UBC-Rocket/WB-AV-4510-CAN/README.md

# Whistler Blackcomb Data Acquisition Board

Altium PCB files for Whistler Blackcomb's Data acquisition boards. There will be three of these on the final rocket connected to our main flight computer. The firmware for this PCB can be found [here](https://github.com/UBC-Rocket/WB-DAQ-Firmware). 
