UBC-Rocket/WB-AV-4510-CAN/WB-AV-4510-DAQ-BOM-INSTOCK-REVA.xlsx

Index | Quantity x2 | Quantity x3 | Quantity | Part Number | Manufacturer Part Number | Description | Customer Reference |  | Available | Backorder | Unit Price | Extended Price CAD
1 | 4 | 6 | 2 | 57478446 | 5747844-6 | CONN D-SUB RCPT 9POS R/A SLDR | J1, J4 |  | 0 | 2 | 4.24 | 8.48
2 | 4 | 6 | 2 | SAM1222-02-ND | SSW-102-02-T-S | CONN RCPT 2POS 0.1 TIN PCB | J2, J3 |  | 2 | 0 | 0.39 | 0.78
3 | 8 | 12 | 4 | A34091-ND | 1-5747150-6 | CONN D-SUB RCPT 9POS VERT SLDR | J7, J8, J9, J10 |  | 4 | 0 | 9.36 | 37.44
4 | 2 | 3 | 1 | SAM8799-ND | FTSH-105-01-L-DV-K | CONN HEADER SMD 10POS 1.27MM | P1 |  | 0 | 1 | 3.94 | 3.94
5 | 2 | 3 | 1 | 568-13334-ND | MK66FX1M0VLQ18 | IC MCU 32BIT 1MB FLASH 144LQFP | U4 |  | 1 | 0 | 33.56 | 33.56
6 | 46 | 69 | 23 | 478-3726-1-ND | 0603YC104JAT2A | CAP CER 0.1UF 16V X7R 0603 | C25-C32, C6-C15, C59, C65, C70, C75, C76 | C25-C32, C6-C15, C59, C65, C70, C75, C76 | 18 | 0 | 0.201 | 3.62
7 | 8 | 12 | 4 | MCP33121-05-E/MS-ND | MCP33121-05-E/MS | IC ADC 14BIT SAR 10MSOP | *1, *3, *5, *7 |  | 4 | 0 | 5.76 | 23.04
8 | 6 | 9 | 3 | 490-6389-1-ND | GRM1885C2A101JA01J | CAP CER 100PF 100V C0G/NP0 0603 | C1, C2, C3 |  | 3 | 0 | 0.15 | 0.45
9 | 4 | 6 | 2 | 1276-2064-1-ND | CL10B472KB8NFNC | CAP CER 4700PF 50V X7R 0603 | C4, C5 |  | 2 | 0 | 0.14 | 0.28
10 | 2 | 3 | 1 | 399-8147-1-ND | C1206C105K5RACTU | CAP CER 1UF 50V X7R 1206 | C24 |  | 1 | 0 | 0.38 | 0.38
11 | 4 | 6 | 2 | 732-7566-1-ND | 885012208019 | CAP CER 22UF 10V X7R 1206 | C33, C34 |  | 2 | 0 | 1.05 | 2.10
12 | 4 | 6 | 2 | 399-3229-1-ND | C1206C226K9PACTU | CAP CER 22UF 6.3V X5R 1206 | C37, C38 |  | 2 | 0 | 0.73 | 1.46
13 | 2 | 3 | 1 | 1276-2003-1-ND | CL10B223KB8NNWC | CAP CER 0.022UF 50V X7R 0603 | C39 |  | 1 | 0 | 0.14 | 0.14
14 | 8 | 12 | 4 | 1276-2876-1-ND | CL31A106KBHNNNE | CAP CER 10UF 50V X5R 1206 | C40, C41, C48, C49 |  | 4 | 0 | 0.46 | 1.84
15 | 8 | 12 | 4 | 493-2286-1-ND | UUD1V330MCL1GS | CAP ALUM 33UF 20% 35V SMD | C42, C43, C50, C51 |  | 4 | 0 | 0.71 | 2.84
16 | 8 | 12 | 4 | 399-1155-1-ND | C0805C472K5RACTU | CAP CER 4700PF 50V X7R 0805 | C44, C45, C52, C54 |  | 4 | 0 | 0.14 | 0.56
17 | 8 | 12 | 4 | 399-6944-1-ND | C0805C223K1RACAUTO | CAP CER 0.022UF 100V X7R 0805 | C46, C47, C53, C55 |  | 4 | 0 | 0.49 | 1.96
 | 16 | 24 | 8 | 587-1242-1-ND |  |  | C57,60,62,63,67,68,71,73
~~18~~ | ~~42~~ | ~~63~~ | ~~21~~ | ~~478-3714-1-ND~~ | ~~06033C104KAT2A~~ | ~~CAP CER 0.1UF 25V X7R 0603~~ | ~~C56-C76~~ |  | ~~21~~ | ~~0~~ | ~~0.057~~ | ~~1.20~~
19 | 4 | 6 | 2 | 1727-1349-1-ND | PMEG6030EVPX | DIODE SCHOTTKY 60V 3A SOD128 | D3, D4 |  | 2 | 0 | 0.61 | 1.22
20 | 2 | 3 | 1 | SMAJ24A-E3/5AGICT-ND | SMAJ24A-E3/5A | TVS DIODE 24V 38.9V DO214AC | D5 |  | 1 | 0 | 0.53 | 0.53
21 | 2 | 3 | 1 | 609-4616-1-ND | 10118193-0001LF | CONN RCPT USB2.0 MICRO B SMD R/A | J5 |  | 1 | 0 | 0.65 | 0.65
22 | 2 | 3 | 1 | 114-00841-68-1-ND | 114-00841-68 | CONN MICRO SD CARD PUSH-PULL R/A | J6 |  | 1 | 0 | 1.71 | 1.71
23 | 2 | 3 | 1 | 732-1266-1-ND | 744774047 | FIXED IND 4.7UH 3A 71 MOHM SMD | L1 |  | 1 | 0 | 2.55 | 2.55
24 | 20 | 30 | 10 | 732-4994-1-ND | 150120YS75000 | LED YELLOW CLEAR 1206 SMD | LED1, LED2, LED3, LED4, LED5, LED6, LED7, LED8, |  | 10 | 0 | 0.29 | 2.90
25 | 2 | 3 | 1 | 732-4993-1-ND | 150120VS75000 | LED GREEN CLEAR 1206 SMD | LED9 |  | 1 | 0 | 0.29 | 0.29
26 | 2 | 3 | 1 | 732-4989-1-ND | 150120BS75000 | LED BLUE CLEAR 1206 SMD | LED12 |  | 1 | 0 | 0.29 | 0.29
27 | 2 | 3 | 1 | 732-4991-1-ND | 150120RS75000 | LED RED CLEAR 1206 SMD | LED13 |  | 1 | 0 | 0.29 | 0.29
28 | 2 | 3 | 1 | XC1839CT-ND | ECS-160-8-30B-CKM | CRYSTAL 16.0000MHZ 8PF SMD | OSCILLATOR1 |  | 1 | 0 | 1.46 | 1.46
29 | 30 | 45 | 15 | 13-RT0603BRD0722RLCT-ND | RT0603BRD0722RL | RES SMD 22 OHM 0.1% 1/10W 0603 | R1-R6,R60-R63,R20-R24 |  | 15 | 0 | 0.396 | 5.94
30 | 2 | 3 | 1 | 541-1.00KHCT-ND | CRCW06031K00FKEA | RES SMD 1K OHM 1% 1/10W 0603 | R7 |  | 1 | 0 | 0.14 | 0.14
31 | 8 | 12 | 4 | P1.00MLCT-ND | ERJ-2RKF1004X | RES SMD 1M OHM 1% 1/10W 0402 | R25, R27, R31, R33 |  | 4 | 0 | 0.14 | 0.56
32 | 2 | 3 | 1 | P330HCT-ND | ERJ-3EKF3300V | RES SMD 330 OHM 1% 1/10W 0603 | R38 |  | 1 | 0 | 0.14 | 0.14
33 | 2 | 3 | 1 | 311-150HRCT-ND | RC0603FR-07150RL | RES SMD 150 OHM 1% 1/10W 0603 | R40 |  | 1 | 0 | 0.14 | 0.14
34 | 2 | 3 | 1 | P18.0KHCT-ND | ERJ-3EKF1802V | RES SMD 18K OHM 1% 1/10W 0603 | R43 |  | 1 | 0 | 0.14 | 0.14
35 | 2 | 3 | 1 | 541-6.20KHCT-ND | CRCW06036K20FKEA | RES SMD 6.2K OHM 1% 1/10W 0603 | R44 |  | 1 | 0 | 0.14 | 0.14
36 | 2 | 3 | 1 | 541-16.0KHCT-ND | CRCW060316K0FKEA | RES SMD 16K OHM 1% 1/10W 0603 | R45 |  | 1 | 0 | 0.14 | 0.14
37 | 2 | 3 | 1 | 311-2105-1-ND | AT0603DRD0710KL | RES SMD 10K OHM 0.5% 1/10W 0603 | R46 |  | 1 | 0 | 0.3 | 0.30
38 | 8 | 12 | 4 | P34KDACT-ND | ERA-6AEB3402V | RES 34K OHM 0.1% 1/8W 0805 | R50, R51, R56, R57 |  | 4 | 0 | 0.45 | 1.80
39 | 8 | 12 | 4 | YAG4965CT-ND | RT0805BRE071K18L | RES SMD 1.18K OHM 0.1% 1/8W 0805 | R52, R53, R58, R59 |  | 4 | 0 | 0.58 | 2.32
40 | 2 | 3 | 1 | P8047SCT-ND | EVQ-PLMA15 | SWITCH TACTILE SPST-NO 0.02A 15V | SW1 |  | 1 | 0 | 0.52 | 0.52
41 | 2 | 3 | 1 | 568-8681-1-ND | TJA1048T,118 | IC TRANSCEIVER HALF 2/2 14SO | U1 |  | 0 | 1 | 3.23 | 3.23
42 | 8 | 12 | 4 | MCP6286T-E/OTCT-ND | MCP6286T-E/OT | IC OPAMP GP 1 CIRCUIT SOT23-5 | U6, U7, U8, U9 |  | 4 | 0 | 0.82 | 3.28
43 | 2 | 3 | 1 | MCP1501T-20E/CHYCT-ND | MCP1501T-20E/CHY | IC VREF SERIES 0.1% SOT23-6 | U10 |  | 0 | 1 | 1.16 | 1.16
44 | 2 | 3 | 1 | MCP9808T-E/MSCT-ND | MCP9808T-E/MS | SENSOR DIGITAL -40C-125C 8MSOP | U11 |  | 1 | 0 | 1.63 | 1.63
45 | 2 | 3 | 1 | TS30042-M050QFNRCT-ND | TS30042-M050QFNR | IC REG BUCK 5V 2A 16QFN | U18 |  | 0 | 1 | 3.53 | 3.53
46 | 8 | 12 | 4 | 732-6215-1-ND | 171032401 | DC DC CONVERTER 5-24V | U19, U20, U21, U22 |  | 4 | 0 | 23.28 | 93.12
47 | 16 | 24 | 8 | 720-1526-1-ND | VJ0603A101JXACW1BC | CAP CER 100PF 50V C0G/NP0 0603 | C16, C17, C18, C19, C20, C21, C22, C23 |  | 8 | 0 | 0.15 | 1.20
48 | 16 | 24 | 8 | P2.0MJCT-ND | ERJ-2GEJ205X | RES SMD 2M OHM 5% 1/10W 0402 | R26, R28, R29, R30, R32, R34, R35, R36 |  | 8 | 0 | 0.14 | 1.12
49 | 2 | 3 | 1 | 1727-3827-1-ND | PESD3V3L4UG,115 | TVS DIODE 3.3V 12V 5TSSOP | U5 |  | 1 | 0 | 0.49 | 0.49
50 | 8 | 12 | 4 | MCP96L00-E/MX | MCP96L00-E/MX | IC THERMOCOUPLE TO I2C 20MQFN | U12, U13, U14, U15 |  | 0 | 4 | 10.27 | 41.08
51 | 4 | 6 | 2 | 445-5205-1-ND | C2012X7S2A105K125AB | CAP CER 1UF 100V X7S 0805 | C35, C36 |  | 2 | 0 | 0.65 | 1.30
52 | 4 | 6 | 2 | SZNUP2105LT1GOSCT-ND | SZNUP2105LT1G | TVS DIODE 24V 44V SOT23-3 | D1, D2 |  | 2 | 0 | 0.56 | 1.12
53 | 4 | 6 | 2 | 296-47565-1-ND | TVS3300DRVR | TVS MIXED TECHNOLOGY 40VC 6WSON | U2, U3 |  | 2 | 0 | 0.94 | 1.88
54 | 2 | 3 | 1 | 296-50411-1-ND | TLV75533PDBVR | IC REG LINEAR 3.3V 500MA SOT23-5 | U16 |  | 1 | 0 | 0.61 | 0.61
55 | 2 | 3 | 1 | 296-47292-1-ND | TPS26600PWPR | IC PWR MGMT EFUSE 60V 16HTSSOP | U17 |  | 0 | 1 | 4.02 | 4.02
56 | 20 | 30 | 10 | RHM680AYCT-ND | KTR03EZPF6800 | RES SMD 680 OHM 1% 1/10W 0603 | R12, R13, R14, R15, R16, R17, R18, R19 |  | 10 | 0 | 0.187 | 1.87
57 | 6 | 9 | 3 | 541-1.5KAYCT-ND | CRCW06031K50DHEAP | RES SMD 1.5K OHM 0.5% 1/10W 0603 | R37, R39, R41 |  | 3 | 0 | 0.42 | 1.26
~~58~~ | ~~2~~ | ~~3~~ | ~~1~~ | ~~738-RMCF0603FT30R0CT-ND~~ | ~~RMCF0603FT30R0~~ | ~~RES 30 OHM 1% 1/10W 0603~~ | ~~R47~~ |  | ~~1~~ | ~~0~~ | ~~0.14~~ | ~~0.14~~
59 | 8 | 12 | 4 | RHM499KAHCT-ND | KTR10EZPF4993 | RES SMD 499K OHM 1% 1/8W 0805 | R48, R49, R54, R55 |  | 4 | 0 | 0.25 | 1.00
60 | 2 | 3 | 1 | 50-ECS-.327-6-34QN-CT-ND | ECS-.327-6-34QN-TR | CRYSTAL 32.7680KHZ 6PF SMD | CRYSTAL1 |  | 1 | 0 | 1.13 | 1.13
 | 8 | 12 | 4 | 478-F981A106MMUAJ6CT-ND |  |  | C56,C61,C66,C72
 |  |  | 4 | 399-7867-1-ND |  |  | C58,C64,C69,C74
 |  |  | 1 | 2019-RK73H1JTTD7153FCT-ND |  |  | R42
 |  |  |  | RK73H1JTTD3002F (https://www.digikey.ca/en/products/detail/koa-speer-electronics-inc/RK73H1JTTD3002F/9844912) |  |  | R47
