UBC-Rocket/WB-AV-4510-CAN/(list of files, drawings)

Other design files:
24V Regulators.SchDoc
CANbus.SchDoc
DAQ and Actuators.SchDoc
MCU.SchDoc
Power.SchDoc
Temp_Sensor.SchDoc
Thermocouple.SchDoc
WB-AV-4510-CAN.PcbDoc
WB-AV-4510-CAN.PrjPcb
WB-AV-4510-CAN.SchDoc
WB-AV-4510-DAQ.PcbLib
WB-AV-4510-DAQ.SchLib
