UBC-Rocket/WB-AV-4510-CAN/(threads)

Thread 10 (2021-10-24):

U17 U18 E-Fuse and Switching Regulator Missing from board

davinbirdi, 2021-10-24:
**U17: E-Fuse (TPS26600PWPR)**
https://www.digikey.ca/en/products/detail/texas-instruments/TPS26600PWPR/6199305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
https://www.ti.com/lit/ds/symlink/tps2660.pdf?HQS=dis-dk-null-digikeymode-dsf-pf-null-wwe&ts=1635100487170

**U18: Voltage Regulator**
https://www.digikey.ca/en/products/detail/semtech-corporation/TS30042-M050QFNR/6605522

U17 is E-Fuse that inputs in the 7s net and outputs to the 7s_F net (presumably fused).
U18 is a Voltage regulator that inputs the 7s_F net and outputs to PG (then to 3.3V) and 5.5V

ToDo: Currently cannot connect 24V or 7s to board to power microcontroller and also toggle 24V outputs. Will look at getting the parts and adding to board.

Note: U1 also missing will do separate Issue

misprit7, 2021-11-23:
For now we can just power the board and high side switch separately, so this isn't the end of the world. For the next iteration of the PCB we'll place them.

Closed 2021-11-23.

Thread 12 (2021-11-23):

ADC SPI Pins Reversed

misprit7, 2021-11-23:
The MOSI and MISO pins of the 14 bit analog to digital converters are reversed, which means that we can't read their output. To fix this all that needs to be done is wire the MOSI and MISO pins to the MCU as they are except switched.

As a temporary stop gap if we really needed to use the ADCs before the next iteration we could bit bang SPI, but with an RTOS that might be tricky and given we won't use it in the long run I'd prefer not to.

Reference: [The ADCs in question](http://ww1.microchip.com/downloads/en/DeviceDoc/MCP33131-MCP33121-MCP33111-Family-Data-Sheet-DS20006122A.pdf)

misprit7, 2021-11-23:
Just to note that when I was debugging why I couldn't read from them I found that they were reading the given voltage seemingly correctly, so the rest of their connections are likely correct.

Closed 2022-01-12.

Thread 13 (2021-11-23):

Mirrored High Side Switches

misprit7, 2021-11-23:
The high side switches have pins that are mirrored to their actual functionality, presumably due to some misunderstanding of a bottom down/top down view. Right now we thought they were wired for SPI, but in reality we wired them to be controlled directly via digital inputs. To fix this issue we need to provide the correct pin assignments to Altium.

Whether we should try to keep SPI or just use the direct inputs is up for discussion, we'll have to talk about it. Especially now that we've quote-unquote "tested" the direct inputs, it might be easier to switch to that.

Reference: [High side switch datasheet](https://www.nxp.com/docs/en/data-sheet/MC06XS4200.pdf)

Closed 2022-01-12.

Thread 14 (2021-12-05):

Test Points Header Distances

davinbirdi, 2021-12-05:
Change the test point single probing points to constant header distances.

See the current board and how crooked the single headers are when soldered individually. Better to keep headers together.

misprit7, 2022-03-09:
Fixed on the latest version.

Closed 2022-03-09.

Thread 15 (2021-12-17):

Thermocouple I2C Pullup Resistors

misprit7, 2021-12-17:
The thermocouple amplifiers use I2C to communicate with the MCU, but the protocol requires pull up resistors for SDA and SCL that aren't there. To fix this we need to add pull up resistors on SDA1, SDA3, SCL1 and SCL3 (and whatever other I2C lines there are).

Also note that internal pull resistors might be a temporary fix, I haven't confirmed this yet. However this isn't a good long term solution because they have much too high of a resistance and will cause timing issues with the signal.

misprit7, 2021-12-19:
Just tested this more, surprisingly the communication actually works us even without external pullup resistors by instead using the internal pull up resistors of the chip. These resistors are too high by a factor of 4 or 5 to act as pullup resistors for normal I2C communication, but as long as you keep the baud rate relatively low it works fine. At a baud rate of 10,000 everything worked perfectly, but at around 100,000 errors started to pop up every so often. You can see the effect of the large RC constant when you probe it:

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

As good practice the next iteration should have pull up resistors regardless though. Also I tested all the thermocouple amplifiers and they seem to work (I didn't try and measure their precision or anything but they could detect that room temperature was ~20C and my finger was ~30C).

misprit7, 2022-03-09:
This was fixed by Eric a while ago, going to close this

Closed 2022-03-09.

Thread 18 (2022-01-28):

Floating Analog Ground & VREFL

davinbirdi, 2022-01-28:
Pin 33 is the VREFL for on-chip ADCs.

When reading from ADCs there is an offset of 800mv where it reads 0 and is consistent. The issue is being unable to measure below 800mV as the range only goes to -253 which stops at ~600mV.

Read page 1000 of the [big manual for application information.](https://www.pjrc.com/teensy/K66P144M180SF5RMV2.pdf)

We have temporarily connected a wire between this point and ground, but for the next revision please connect the via that seems to have been forgotten to be connected to the ground plane.

> 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

misprit7, 2022-03-09:
Fixed this, now AGND is tied directly to GND.

Closed 2022-03-09.

Thread 22 (2022-02-27):

Verify High-Side Switches are output to the correct pins of connectors

davinbirdi, 2022-02-27:
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

This looks nets aren't connected properly. If it is specifically done this way, it's all good; but it's not it might be better to have fixed.

misprit7, 2022-03-09:
This has been fixed, this was a result of the high side switch mixup.

Closed 2022-03-09.

Thread 23 (2022-03-02):

Fix Compiler Warnings

misprit7, 2022-03-02:
Fix all the compiler warnings/errors currently generated on the schematic side of things.

misprit7, 2022-03-02:
Also fixed AGND being completely isolated from GND by connecting them.

misprit7, 2022-03-02:
A note about why this is necessary: this would have been uncaught other wise:
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
The +5 there should be +5V, which would surely cause stuff to just not work since the power wouldn't be connected.

misprit7, 2022-03-09:
This has been finished.

Closed 2022-03-09.

Thread 26 (2022-03-13):

Purchase PCB

misprit7, 2022-03-13:
Buy the Rev C PCB from JLCPCB.

misprit7, 2022-03-13:
I want to do a review of both this and the FC tomorrow before we order though.

Esouder, 2022-03-13:
Final checks:

- [ ] Hi-side switch pins
- [ ] ADC MISO/MOSI
- [ ] TC Pullups

Esouder, 2022-03-27:
🎉🎉🎉

Closed 2022-03-27.
