UBC-Rocket/WB-AV-4510-CAN/(commit log)

2020-09-01 added connectors and CAN ICs
    [WB-AV-4510-CAN.PcbDoc, WB-AV-4510-CAN.PrjPcb, WB-AV-4510-CAN.SchDoc]
2020-09-02 Schematic restructure
    [CANbus.SchDoc, MCU.SchDoc, WB-AV-4510-CAN.PcbDoc, WB-AV-4510-CAN.PrjPcb, WB-AV-4510-CAN.SchDoc]
2020-09-03 added 24v to 5v linear reg
    [MCU.SchDoc, WB-AV-4510-CAN.PcbDoc, WB-AV-4510-CAN.PrjPcb]
2020-09-03 Finished wiring 24V to 5V reg
    [MCU.SchDoc, WB-AV-4510-CAN.PcbDoc]
2020-09-04 3.3 and 3.3_A linear reg
    [MCU.SchDoc, WB-AV-4510-CAN.PcbDoc]
2020-09-04 Programmer wiring
    [MCU.SchDoc, WB-AV-4510-CAN.PcbDoc]
2020-09-05 eFuse symbol
    [MCU.SchDoc, WB-AV-4510-CAN.PrjPcb]
2020-09-06 Corrected programmer pins
    [MCU.SchDoc, WB-AV-4510-CAN.PcbDoc]
2020-09-10 efuse footprint and schematic initialization
    [Efuse.SchDoc, MCU.SchDoc, WB-AV-4510-CAN.PcbDoc, WB-AV-4510-CAN.PrjPcb, WB-AV-4510-CAN.SchDoc]
2020-09-13 efuse output cap
    [Efuse.SchDoc, MCU.SchDoc, WB-AV-4510-CAN.PcbDoc, WB-AV-4510-CAN.SchDoc]
2020-09-13 Changed to MK66 MCU, updated libraries
    [CANbus.SchDoc, MCU.SchDoc, WB-AV-4510-CAN.PcbDoc, WB-AV-4510-CAN.PrjPcb]
2020-09-16 temp sensor and mk66f power nets
    [Efuse.SchDoc, MCU.SchDoc, Temp_Sensor.SchDoc, WB-AV-4510-CAN.PcbDoc, WB-AV-4510-CAN.PrjPcb, WB-AV-4510-CAN.SchDoc]
2020-09-20 Added CS sheet entries in main sch for TCs
    [MCU.SchDoc]
2020-09-20 fixing last commit, added CS sheet entries to sch
    [WB-AV-4510-CAN.SchDoc]
2020-09-20 Added thermocouple AliExpress PCB connector
    [Thermocouple.SchDoc, WB-AV-4510-CAN.PcbDoc, WB-AV-4510-CAN.PrjPcb]
2020-09-25 Added eFuses
    [Efuse.SchDoc, MCU.SchDoc, Temp_Sensor.SchDoc, Thermocouple.SchDoc, WB-AV-4510-CAN.PcbDoc, WB-AV-4510-CAN.PrjPcb, WB-AV-4510-CAN.SchDoc]
2020-09-27 Placed components
    [Efuse.SchDoc, Thermocouple.SchDoc, WB-AV-4510-CAN.PcbDoc, WB-AV-4510-CAN.PrjPcb]
2020-09-30 added dsub connectors and ADC footprint
    [Efuse.SchDoc, WB-AV-4510-CAN.PcbDoc, WB-AV-4510-CAN.PrjPcb]
2020-10-01 ADC schematics
    [Efuse.SchDoc, MCU.SchDoc, WB-AV-4510-CAN.PcbDoc, WB-AV-4510-CAN.SchDoc]
2020-10-01 Placed ADC components
    [WB-AV-4510-CAN.PcbDoc]
2020-10-02 imported rules from fc, added layers
    [WB-AV-4510-CAN.PrjPcb]
2020-10-03 added USB connector
    [MCU.SchDoc, WB-AV-4510-CAN.PcbDoc]
2020-10-04 added SD card
    [MCU.SchDoc, WB-AV-4510-CAN.PrjPcb, WB-AV-4510-CAN.SchDoc]
2020-10-04 deleted extra Reset net
    [MCU.SchDoc]
2020-10-04 Reassigned SPI pins, placed USB and SD card
    [CANbus.SchDoc, Efuse.SchDoc, MCU.SchDoc, Temp_Sensor.SchDoc, Thermocouple.SchDoc, WB-AV-4510-CAN.SchDoc]
2020-10-04 Removed one ADC, rewired DSPI
    [Efuse.SchDoc, MCU.SchDoc]
2020-10-10 Fixed ADC wiring, added buffers and caps
    [Efuse.SchDoc, MCU.SchDoc, WB-AV-4510-CAN.SchDoc]
2020-10-10 rewire MISO
    [Efuse.SchDoc]
2020-10-11 adc wiring and added ground connections to d-sub
    [Efuse.SchDoc]
2020-10-11 changed TC connector, reorganized placement
    [Thermocouple.SchDoc]
2020-10-11 Added capacitors and inductors for MCU
2020-10-14 Added mounting holes, placed ADC components
    [Efuse.SchDoc, MCU.SchDoc, WB-AV-4510-CAN.PrjPcb]
2020-10-16 Added No Connect to MCU pins
    [MCU.SchDoc]
2020-10-18 Added connector labels and logo
2020-10-19 Replaced ADCs and buffers
    [Efuse.SchDoc, MCU.SchDoc, WB-AV-4510-CAN.SchDoc]
2020-10-25 changed MCP3204s to TSSOP package
    [Efuse.SchDoc]
2020-10-25 added back designators on adcs
    [Efuse.SchDoc]
2020-10-25 decrease board size
2020-10-25 Added V/I switch and fixed buffer wiring
    [Efuse.SchDoc]
2020-10-25 shrinked board shape, changed diode footprint
    [MCU.SchDoc, WB-AV-4510-CAN.PrjPcb]
2020-10-25 Moved Canbus up
2020-10-25 Included diode library in repo
    [MCU.SchDoc, WB-AV-4510-CAN.PrjPcb]
2020-11-01 modified board shape and fixed room errors
2020-11-08 Added LEDs, changed bootloader footprint
    [CANbus.SchDoc, Efuse.SchDoc, MCU.SchDoc, Power.SchDoc, Temp_Sensor.SchDoc, Thermocouple.SchDoc, WB-AV-4510-CAN.PrjPcb, WB-AV-4510-CAN.SchDoc]
2020-11-08 Placed LEDs and reorganized power components
    [Efuse.SchDoc, Power.SchDoc]
2020-11-17 Deleted bootloader and header pins
    [MCU.SchDoc]
2020-11-18 Added 24V reverse circuit protection
    [Power.SchDoc, WB-AV-4510-CAN.PrjPcb]
2020-11-18 shrink pcb
2020-11-18 some updates and shrinking board
2020-11-21 Added TVS diodes on debugger lines
    [MCU.SchDoc, WB-AV-4510-CAN.PrjPcb]
2020-11-23 Added USB power, test points, LEDs
    [CANbus.SchDoc, MCU.SchDoc, Power.SchDoc, WB-AV-4510-CAN.PrjPcb]
2020-11-27 added e-fuse with reverse input protection to 24v reg, changed diode on USB and 5v reg
    [CANbus.SchDoc, Efuse.SchDoc, MCU.SchDoc, Power.SchDoc, Temp_Sensor.SchDoc, WB-AV-4510-CAN.PrjPcb, WB-AV-4510-DAQ.PcbLib, WB-AV-4510-DAQ.SchLib]
2020-11-28 Rearranged power layout, placed 24V efuse
    [Power.SchDoc, WB-AV-4510-CAN.PrjPcb]
2020-11-28 Changed TC caps from 0402 to 0603
    [Thermocouple.SchDoc]
2020-11-29 change connector orientation and schematic name
    [DAQ and Actuators.SchDoc, WB-AV-4510-CAN.PrjPcb, WB-AV-4510-CAN.SchDoc]
2020-11-29 Modified placing, fixed designators
    [Power.SchDoc]
2020-11-29 updated resistor values for 24V eFuse
    [Power.SchDoc]
2020-12-02 changed 5V reg Power good pull up voltage to 3.3V
    [Power.SchDoc]
2020-12-06 fixed power port naming, rotated headers for easier access, decreased board size by a few mm
    [CANbus.SchDoc, MCU.SchDoc, Power.SchDoc, Thermocouple.SchDoc, WB-AV-4510-CAN.SchDoc]
2020-12-06 spread out LEDs
    [Thermocouple.SchDoc]
2020-12-06 added extra efuse
    [DAQ and Actuators.SchDoc]
2020-12-08 added extra TC and efuse, added TC input caps
    [DAQ and Actuators.SchDoc, MCU.SchDoc, Thermocouple.SchDoc, WB-AV-4510-CAN.SchDoc]
2020-12-09 added right angle connectors
    [CANbus.SchDoc]
2020-12-10 added input TVS diodes and 4 24V regs
    [24V Regulators.SchDoc, CANbus.SchDoc, WB-AV-4510-CAN.PrjPcb, WB-AV-4510-CAN.SchDoc, WB-AV-4510-DAQ.PcbLib, WB-AV-4510-DAQ.SchLib]
2020-12-20 placed 24V regs and connectors
    [24V Regulators.SchDoc, WB-AV-4510-CAN.SchDoc]
2020-12-22 EDR placement done
    [24V Regulators.SchDoc, DAQ and Actuators.SchDoc]
2020-12-23 shorter 24v reg output caps
    [24V Regulators.SchDoc]
2020-12-28 shrank board
2020-12-29 fixed 3.3V_D nets and shrank width of board
    [MCU.SchDoc, Power.SchDoc]
2020-12-30 Connected 24V regulator power pad and assigned a regulator to an eFuse
    [24V Regulators.SchDoc, DAQ and Actuators.SchDoc]
2021-01-01 changed fuse input to 7s
    [Power.SchDoc]
2021-01-01 swapped temp sennsor and 5V reg
2021-01-02 Got rid of 3.3V Analog bus because we are no using any of the MCU's Analog interfaces
    [MCU.SchDoc, Power.SchDoc]
2021-01-13 added Microchip ADC with 14 bit resolution footprint and symbol
    [DAQ and Actuators.SchDoc, WB-AV-4510-DAQ.PcbLib, WB-AV-4510-DAQ.SchLib]
2021-01-13 added microchip buffer amplifiers
    [DAQ and Actuators.SchDoc]
2021-01-14 added 1.8V ref
    [DAQ and Actuators.SchDoc, Thermocouple.SchDoc]
2021-01-15 added I2C thermocouple ICs
    [MCU.SchDoc, Thermocouple.SchDoc, WB-AV-4510-DAQ.PcbLib, WB-AV-4510-DAQ.SchLib]
2021-01-15 deleted old TCs and ADCs
    [DAQ and Actuators.SchDoc, MCU.SchDoc, Thermocouple.SchDoc]
2021-01-16 TC schematic done
    [DAQ and Actuators.SchDoc, MCU.SchDoc, Thermocouple.SchDoc, WB-AV-4510-CAN.SchDoc]
2021-01-23 Updated the main schematic and ADC/actuator schematic to finish wiring the ADCs
    [DAQ and Actuators.SchDoc, MCU.SchDoc, WB-AV-4510-CAN.PrjPcb, WB-AV-4510-CAN.SchDoc, WB-AV-4510-DAQ.PcbLib]
2021-01-23 updated 1.8v regulator
    [DAQ and Actuators.SchDoc]
2021-01-23 added changes to pcb
2021-01-24 finished preliminary TC placement and got rid off ADC switch headers
    [DAQ and Actuators.SchDoc, Thermocouple.SchDoc]
2021-01-24 finished preliminary ADC placement
    [DAQ and Actuators.SchDoc]
2021-02-01 Finished placing components and designators
    [CANbus.SchDoc, DAQ and Actuators.SchDoc, MCU.SchDoc]
2021-02-01 got rid off extra 7s bus
    [CANbus.SchDoc]
2021-02-01 fixed baord shape and added 3D models
    [DAQ and Actuators.SchDoc, WB-AV-4510-DAQ.PcbLib]
2021-02-03 Routed CAN and 24V regs
    [Power.SchDoc, WB-AV-4510-CAN.PrjPcb]
2021-02-04 added reg-a power pour
2021-02-06 Did more routing
    [MCU.SchDoc, Thermocouple.SchDoc]
2021-02-07 Done most of signal and ground
    [MCU.SchDoc]
2021-02-08 finished routing nets
    [WB-AV-4510-CAN.PrjPcb]
2021-02-11 updated thermocouples and mcu
    [DAQ and Actuators.SchDoc, MCU.SchDoc, Power.SchDoc, Thermocouple.SchDoc]
2021-02-15 rev a ready for production
    [DAQ and Actuators.SchDoc, WB-AV-4510-CAN.PrjPcb]
2021-03-26 fixed parts links and added BOM
    [CANbus.SchDoc, MCU.SchDoc, Power.SchDoc, Temp_Sensor.SchDoc, Thermocouple.SchDoc, WB-AV-4510-CAN.PrjPcb, WB-AV-4510-DAQ-BOM-INSTOCK-REVA.xlsx, WB-AV-4510-DAQ-BOM-Reduced-Price-Rev-A.xlsx]
2022-01-09 SPI Pin Reversal & High Side Switch Mirroring fixes.
    This commit should include the necessary changes to resolve #12 and #13.
    [MCU.SchDoc]
2022-01-09 Added I2C Pullup resistors to Schematic
    But I have not yet put them into the pcb. Because I don't know how.
    [Thermocouple.SchDoc, WB-AV-4510-CAN.PrjPcb]
2022-01-12 Removed R? resistors and updated PCB
    [CANbus.SchDoc, MCU.SchDoc, Temp_Sensor.SchDoc]
2022-01-21 CAN component switch
    [CANbus.SchDoc, DAQ and Actuators.SchDoc, Power.SchDoc, WB-AV-4510-CAN.PrjPcb]
2022-01-23 PCB update with new components and EEConcierge save
2022-01-23 Commit before extension
    [Power.SchDoc]
2022-01-23 Board extended
    [WB-AV-4510-CAN.PrjPcb]
2022-01-30 Finished most routing
    [Power.SchDoc]
2022-01-31 Fixed high side switch routing
    [DAQ and Actuators.SchDoc, WB-AV-4510-CAN.PrjPcb]
2022-02-09 Switchedout main 3.3V regulator
    [Power.SchDoc]
2022-02-09 Got rid of gitignore junk
    [WB-AV-4510-CAN.PrjPcb]
2022-02-25 just in case
    [24V Regulators.SchDoc, CANbus.SchDoc, DAQ and Actuators.SchDoc, Power.SchDoc, Thermocouple.SchDoc, WB-AV-4510-CAN.PrjPcb]
2022-03-02 Changed port types for spi and can to match functionality
    [CANbus.SchDoc, DAQ and Actuators.SchDoc, MCU.SchDoc, WB-AV-4510-CAN.SchDoc]
2022-03-02 Fixed all errors except component revision out of date ones
    [CANbus.SchDoc, DAQ and Actuators.SchDoc, MCU.SchDoc, Temp_Sensor.SchDoc, Thermocouple.SchDoc, WB-AV-4510-CAN.SchDoc]
2022-03-04 Added back files I forgot to save
    [24V Regulators.SchDoc, Power.SchDoc]
2022-03-04 saving most components replaceed
    [24V Regulators.SchDoc, DAQ and Actuators.SchDoc, MCU.SchDoc, Power.SchDoc, WB-AV-4510-CAN.PrjPcb]
2022-03-04 saving most components replaceed 2
    [MCU.SchDoc, Power.SchDoc]
2022-03-06 finishing purchased replacements and reducing design check errors
    [CANbus.SchDoc, DAQ and Actuators.SchDoc, Power.SchDoc, Thermocouple.SchDoc, WB-AV-4510-CAN.PrjPcb]
2022-03-09 Fixed high side switches routing
    [CANbus.SchDoc]
2022-03-13 moved designator text for power testpoints
    [DAQ and Actuators.SchDoc]
2022-03-13 Rev. B Fab Outputs
    [WB-AV-4510-CAN.GBL, WB-AV-4510-CAN.GBO, WB-AV-4510-CAN.GBS, WB-AV-4510-CAN.GKO, WB-AV-4510-CAN.GM1, WB-AV-4510-CAN.GTL, WB-AV-4510-CAN.GTO, WB-AV-4510-CAN.GTP]
